veethahavya-CU-cz/pico_sm_sensors/3dp/fusion360/housing_control_top.stl

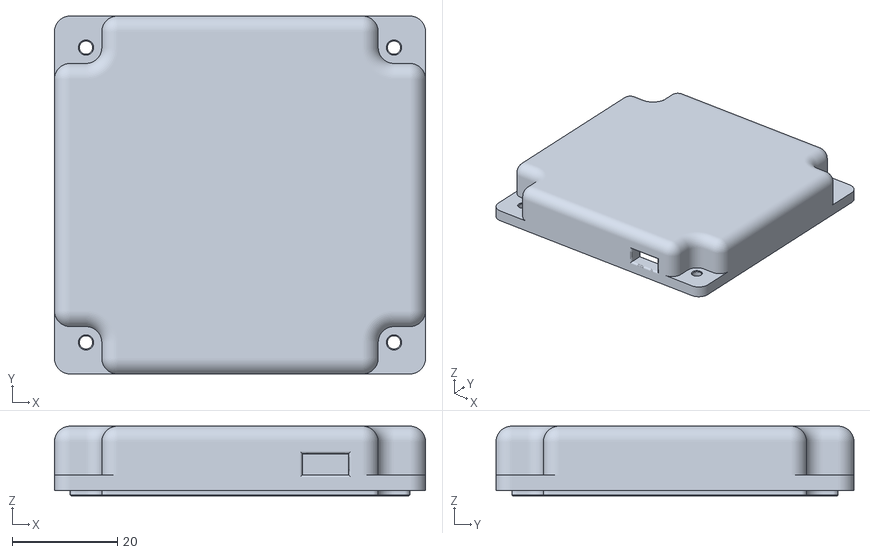
[picture p1: CAD file, 2024-07-04]
3dp/fusion360/housing_control_top.stl
70.5 x 68.0 x 13.2
