veethahavya-CU-cz/pico_sm_sensors/(list of files, cad)

Other CAD files:
3dp/fusion360/housing_power_v3.0.0.f3z
3dp/fusion360/housing_sms_v3.0.0.f3z
