veethahavya-CU-cz/pico_sm_sensors/fritzing/out/wiring_bb.pdf

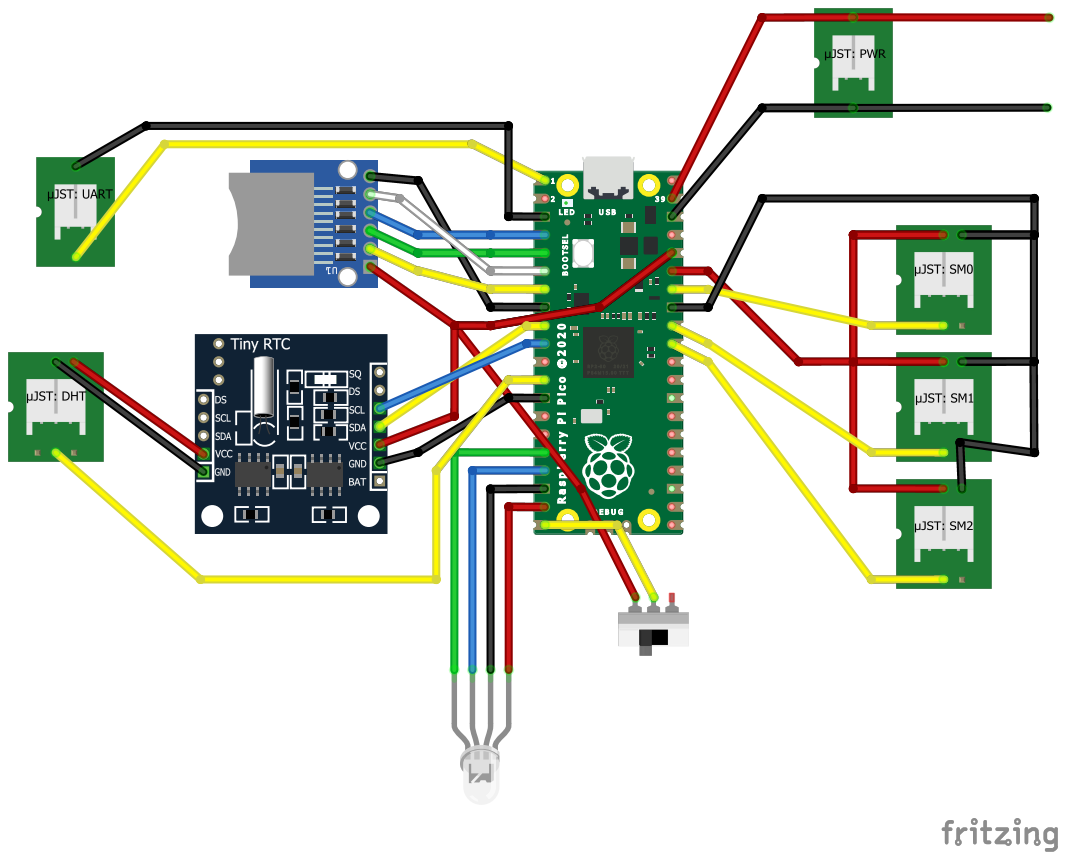
[picture p2: page 1]
