veethahavya-CU-cz/pico_sm_sensors/fritzing/out/wiring_schem.pdf

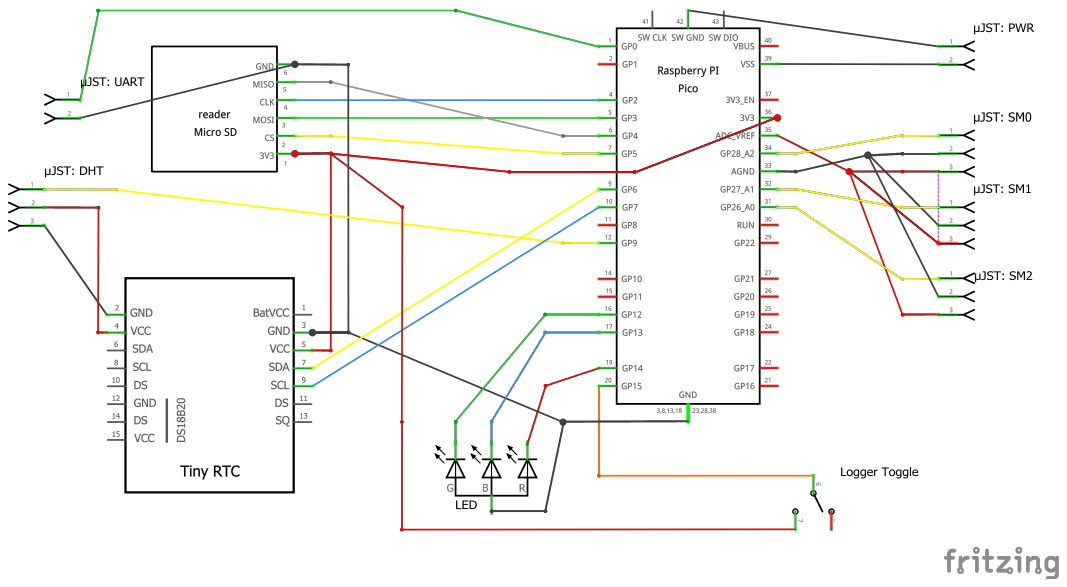
[picture p3: page 1]
