veethahavya-CU-cz/pico_sm_sensors/(list of files, drawings)

Other design files:
fritzing/wiring.fzz
