veethahavya-CU-cz/pico_sm_sensors/fritzing/out/wiring_bb.png

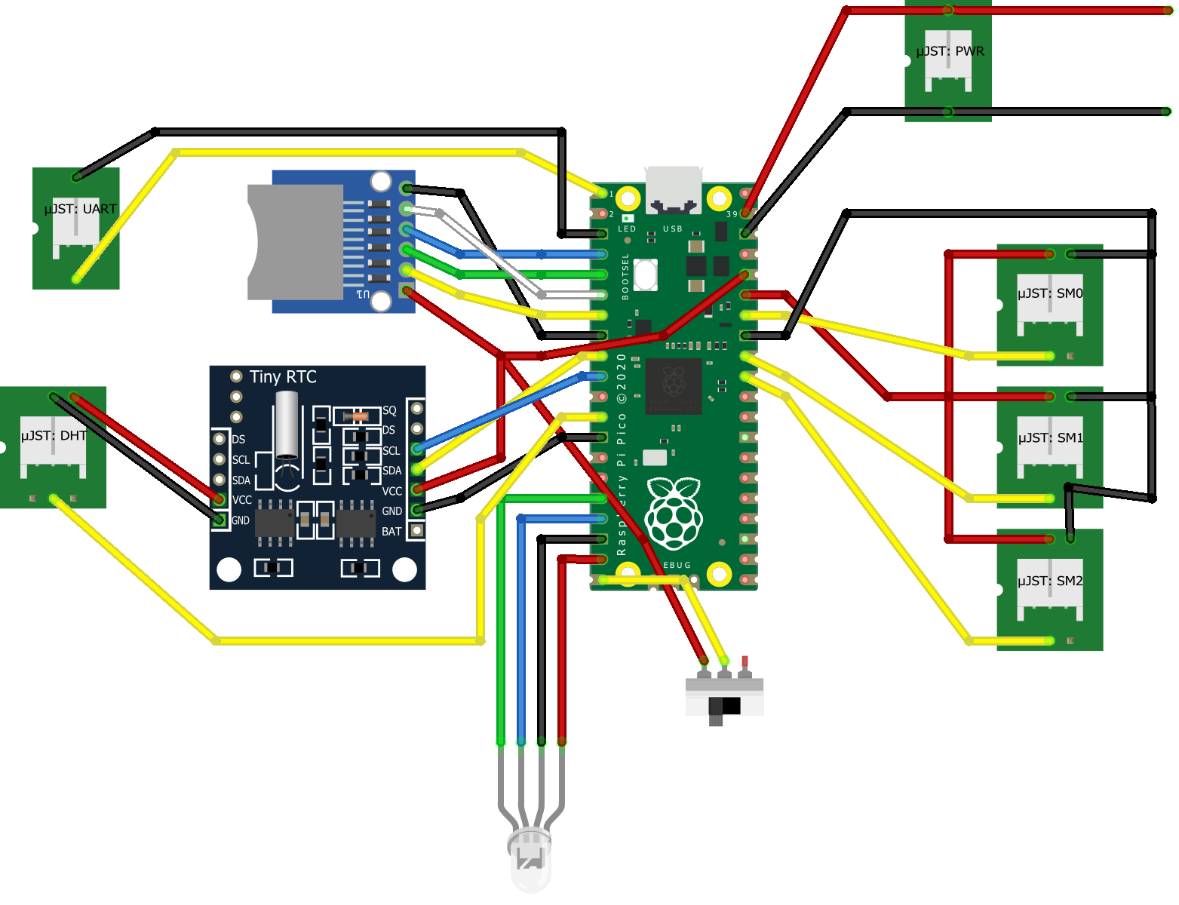
fritzing/out/wiring_bb.png
