veethahavya-CU-cz/pico_sm_sensors/fritzing/out/wiring_schem.png

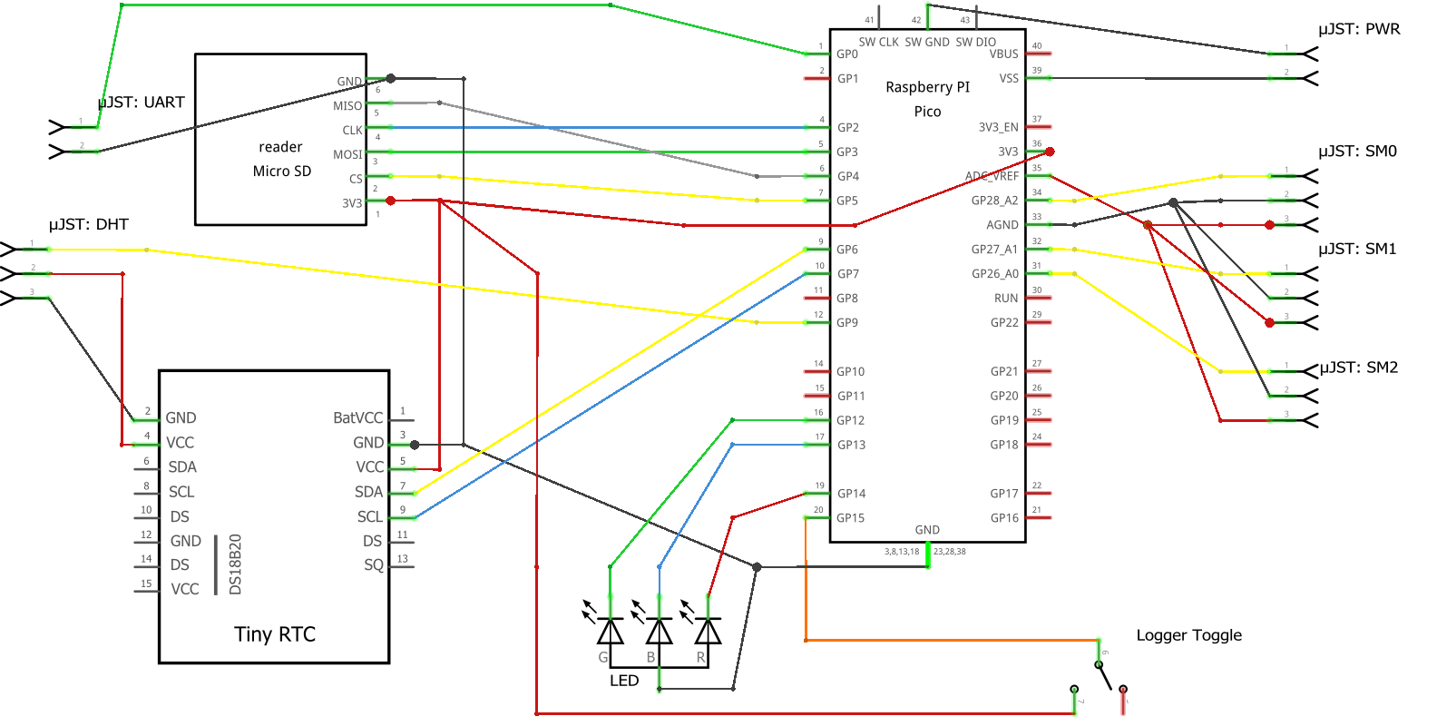
fritzing/out/wiring_schem.png
