veethahavya-CU-cz/pico_sm_sensors/(commit log)

2024-08-04 checkpoint: [PRE] DS1307 overhaul
    [JST_2pin.stp, housing_control.3mf, housing_control_bottom.stl, housing_power.3mf, housing_power_bottom.stl, housing_power_top.stl, uJST_2pin_female.step, uJST_2pin_male.step]
2024-08-17 checkpoint: working automated setup script
    [housing_control.3mf, housing_control_bottom.stl, housing_control_power_0.2.3mf, housing_power v2.1.2.f3z, housing_power v2.2.f3z, housing_power_bottom.stl, housing_power_top.stl, housing_sms v1.1.f3z]
2024-08-21 checkpoint: tested; working copy
    [housing_control_bottom.stl, housing_control_power_0.2.3mf, housing_control_power_sms_0.2.3mf, housing_power_bottom.stl, housing_power_mid.stl, housing_power_top.stl, housing_sms.stl]
2024-08-28 adding data
    [housing_set.3mf]
2024-10-18 - added: new station data - todos: time/wake fixme - cleanup
    [housing_power_v3.0.0.3mf, housing_set.3mf]
2025-02-05 updated flashing script to add manual datetime writing and other fixes
    [machine_config.py]
2025-04-08 tested at Berembadi + data from Berembadi
    [Bechanahalli2_SA_AD_20250208.csv, Bechanahalli2_SA_AD_20250209.csv, Bechanahalli2_SA_AD_20250210.csv, Bechanahalli2_SA_AD_20250211.csv, Bechanahalli2_SA_AD_20250212.csv, Bechanahalli2_SA_AD_20250213.csv, Bechanahalli2_SA_AD_20250214.csv, Bechanahalli2_SA_AD_20250215.csv]
